silmaril56/ArdSecurityGadget/doc/pinout/SecurityGaget1_pin_assign_table.xlsx

Sheet: Arduino UNO
No. | ポート名 | PIN No. | SW pin Ref | 備考
1 | +3.3V | +3.3V | N/A | 周辺device用電源
2 | GND | GND | N/A | 周辺device用GND
3 | I2C(SCL) | A5 | Wire | LIDER接続用(3.3V)
4 | I2C(SDA) | A4 | Wire | LIDER接続用(3.3V)
5 | XSHUT1 | IO2 | 2 | LIDER1リセットpin(Open Drain)
6 | XSHUT2 | IO3 | 3 | LIDER2リセットpin(Open Drain)
7 | UART(Rx) | IO7/IO1 | Serial | BLデバイス通信用UARTポート(3.3V)。HW Serial時はIO1
8 | UART(Tx) | IO6/IO0 | Serial | BLデバイス通信用UARTポート(3.3V)。HW Serial時はIO0
 | Arduino UNO R3 x1
 | 8pin hausing x2
 | 6pin hausing x1

Sheet: BD1
No. | ポート名 | PIN No. | 備考
1 | +3.3V | J1-1 | <-Arduino UNO
2 | GND | J1-2 | <-Arduino UNO
3 | I2C(SCL) | J1-3 | <-Arduino UNO
4 | I2C(SDA) | J1-4 | <-Arduino UNO
5 | XSHUT1 | J1-5 | <-Arduino UNO
6 | XSHUT2 | J1-6 | <-Arduino UNO
7 | UART(Rx) | J1-7 | <-Arduino UNO
8 | UART(Tx) | J1-8 | <-Arduino UNO
9 | +3.3V | J2-1 | ->VL53L1X_1
10 | GND | J2-2 | ->VL53L1X_1
11 | I2C(SCL) | J2-3 | ->VL53L1X_1
12 | I2C(SDA) | J2-4 | ->VL53L1X_1
13 | XSHUT | J2-5 | ->VL53L1X_1
14 | +3.3V | J3-1 | ->VL53L1X_2
15 | GND | J3-2 | ->VL53L1X_2
16 | I2C(SCL) | J3-3 | ->VL53L1X_2
17 | I2C(SDA) | J3-4 | ->VL53L1X_2
18 | XSHUT | J3-5 | ->VL53L1X_2
19 | +3.3V | J4-1 | ->RN42
20 | GND | J4-2 | ->RN42
21 | UART(Rx) | J4-3 | ->RN42
22 | UART(Tx) | J4-4 | ->RN42
 | 8pin socket/hausing x1
 | 5pin socket/hausing x2
 | 4pin socket/hausing x1
 | universal PCB x1

Sheet: VL53L1X
No. | ポート名 | PIN No. | 備考
1 | +3.3V | 5 | 周辺device用電源(3.3V/5.0V)
2 | GND | 6 | 周辺device用GND
3 | I2C(SCL) | 3 | LIDER接続用(3.3V)
4 | I2C(SDA) | 4 | LIDER接続用(3.3V)
5 | XSHUT | 2 | LIDERリセットpin(Open Drain)
6 | GPIO1 | 1 | LIDER割込み端子
 | 6pin hausing x2

Sheet: RN42
No. | ポート名 | PIN No. | 備考
1 | +3.3V | J1-11 | 周辺device用電源(3.3V)
2 | GND | J1-12 | 周辺device用GND
3 | UART(Rx) | J2-7 | 3.3V
4 | UART(Tx) | J2-6 | 3.3V
 | 12pin hausing x2
 | SW Serial使用時はbaud rate 9600bpsまでしか使用できないため、ボード上のDip SW4をONにする。
 | HW Serial使用時はbaud rate 115200bpsで動作するため、ボード上のDip SW4をOFFにする。
 | ボード上のDip SW 1～3はOFFにする。
 | OS上でペアリング後、COMポート番号の大きい方をTera Termにて開くと、LEDの点滅が点灯に代わり、SPP通信結果が表示される。
