silmaril56/ArdSecurityGadget/doc/Security Gadget Commit Log at local/Security Gadget Commit Log at local2.png

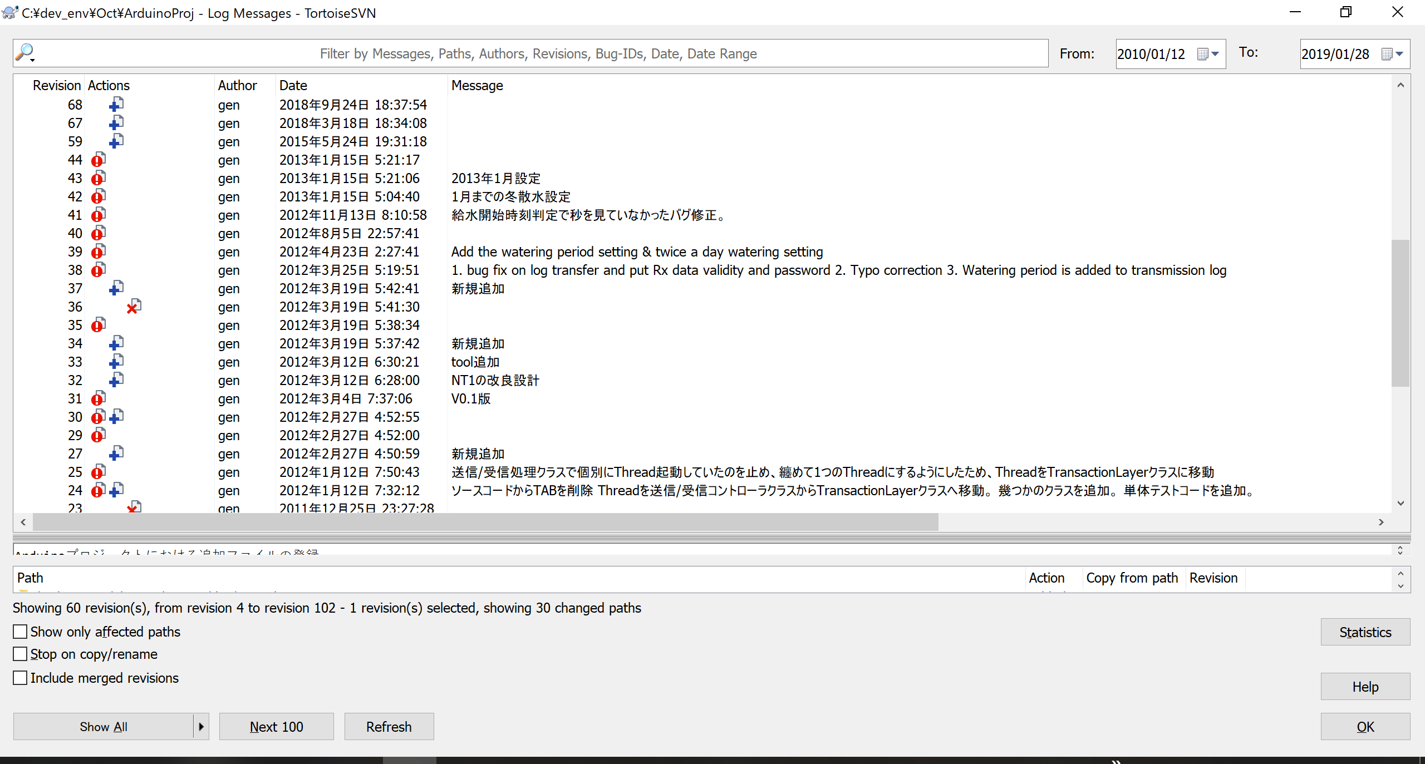
doc/Security Gadget Commit Log at local/Security Gadget Commit Log at local2.png
