silmaril56/ArdSecurityGadget/doc/Security Gadget Commit Log at local/Security Gadget Commit Log at local3.png

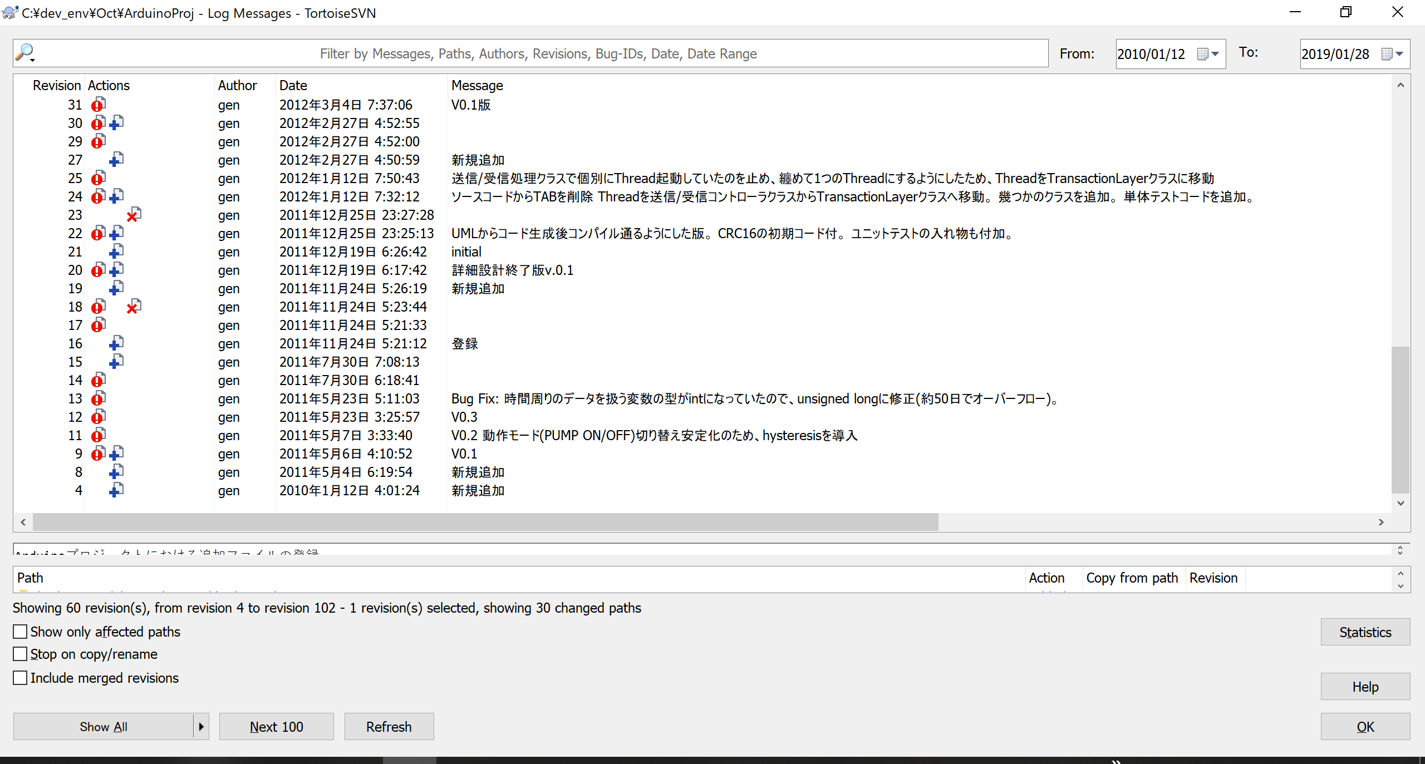
doc/Security Gadget Commit Log at local/Security Gadget Commit Log at local3.png
