silmaril56/ArdSecurityGadget/doc/parts_list/SecurityGaget1_parts_list.xlsx

No. | Item | Parts No. | count | item price | sum price | remark
1 | Arduino UNO R3 | Arduino Uno Rev3 | 1 | 2940円 | 2940円 | 秋月電子にて販売
2 | RN-42使用 Bluetooth無線モジュール評価キット | AE-RN-42 | 1 | 2400円 | 2400円 | 秋月電子にて販売
3 | VL53L1X TOF レーザー測距センサモジュール | VL53L1X | 2 | 1500円 | 3000円 | Strawberry Linuxにて販売
4 | universal PCB | AE-D1 | 1 | 30円 | 30円 | 47mm x 36mm(秋月電子にて販売)
5 | 1 x 12pin hausing | 2226A-10 | 2 | 20円 | 40円 | 2.54mm pitch(10pinにて代用)(秋月電子にて販売)
6 | 1 x 8pin hausing | 2226A-08 | 3 | 15円 | 45円 | 2.54mm pitch(秋月電子にて販売)
7 | 1 x 6pin hausing | 2226A-06 | 3 | 10円 | 30円 | 2.54mm pitch(秋月電子にて販売)
8 | 1 x 5pin hausing | 2226A-05 | 2 | 10円 | 20円 | 2.54mm pitch(秋月電子にて販売)
9 | 1 x 4pin hausing | 2226A-04 | 1 | 10円 | 10円 | 2.54mm pitch(秋月電子にて販売)
10 | 1 x 8 pin socket | FH-1x8SG/RH | 1 | 30円 | 30円 | 2.54mm pitchピン固定(秋月電子にて販売)
11 | 1 x 5 pin socket | FH-1x5SG/RH | 2 | 25円 | 50円 | 2.54mm pitchピン固定(秋月電子にて販売)
12 | 1 x 4 pin socket | FH-1x4SG/RH | 1 | 20円 | 20円 | 2.54mm pitchピン固定(秋月電子にて販売)
13 | AWG26 wire |  | 1 | 441円 | 441円 | 10色入り
14 | 収縮チューブ(1.5K) |  | 1 | 40円 | 40円
15 | DSUB15コネクタ用 pin header |  | 1 | 980円 | 980円 | 100個入(千石電商にて販売)
16 | DSUB15コネクタ用 pin socket |  | 1 | 980円 | 980円 | 100個入(千石電商にて販売)
17 | 15mm角 pin socket |  | 1 | 980円 | 980円 | 100個入(千石電商にて販売)
18 | スズメッキ線 |  | 1 | 210円 | 210円
19 | 7V ACアダプター |  | 1 | 950円 | 950円 | 9V品で代用可
20 | 角材 |  | 1 |  | 0円 | 40 x 40 x 1200mm
21 | 板 |  | 1 |  | 0円 | 30mm～40mm厚のもの
22 | L字金具 |  | 2 |  | 0円 | 4つ穴のもの
23 | ねじ |  | 1 |  | 0円 | 30 x 12mm(L字金具合わせ)
24 | 結束バンド |  | 1 |  | 0円 | 一袋
25 | 反射板 |  | 1 |  | 0円 | スチロール板(白)
 |  |  |  | 総計 | 13196円
