silmaril56/ArdSecurityGadget/(commit log)

2019-01-09 Initial Upload.
    Initial Upload with no capability with BT communication.
    [SecurityGaget1_parts_list.xlsx, SecurityGaget1_pin_assign_table.xlsx, SecurityGaget1_wire_harness_length.xlsx]
2019-01-09 BT communication added for sensor values.
    BT communication added for sensor values.
    Though no LP Filter designed and some bugs still left.
    [CBlueToothComm.cpp, CSecuritySurveillance.h, Definitions.h]
2019-01-13 email/ambient transfer code register
    email/ambient transfer code register.
    Though, there is still some bugs that is failed on retrieving a data from BT.
    [SecuritySurveillance.py]
